haxeko/matter-light-diver/hardware/kicad/output/schematic.pdf

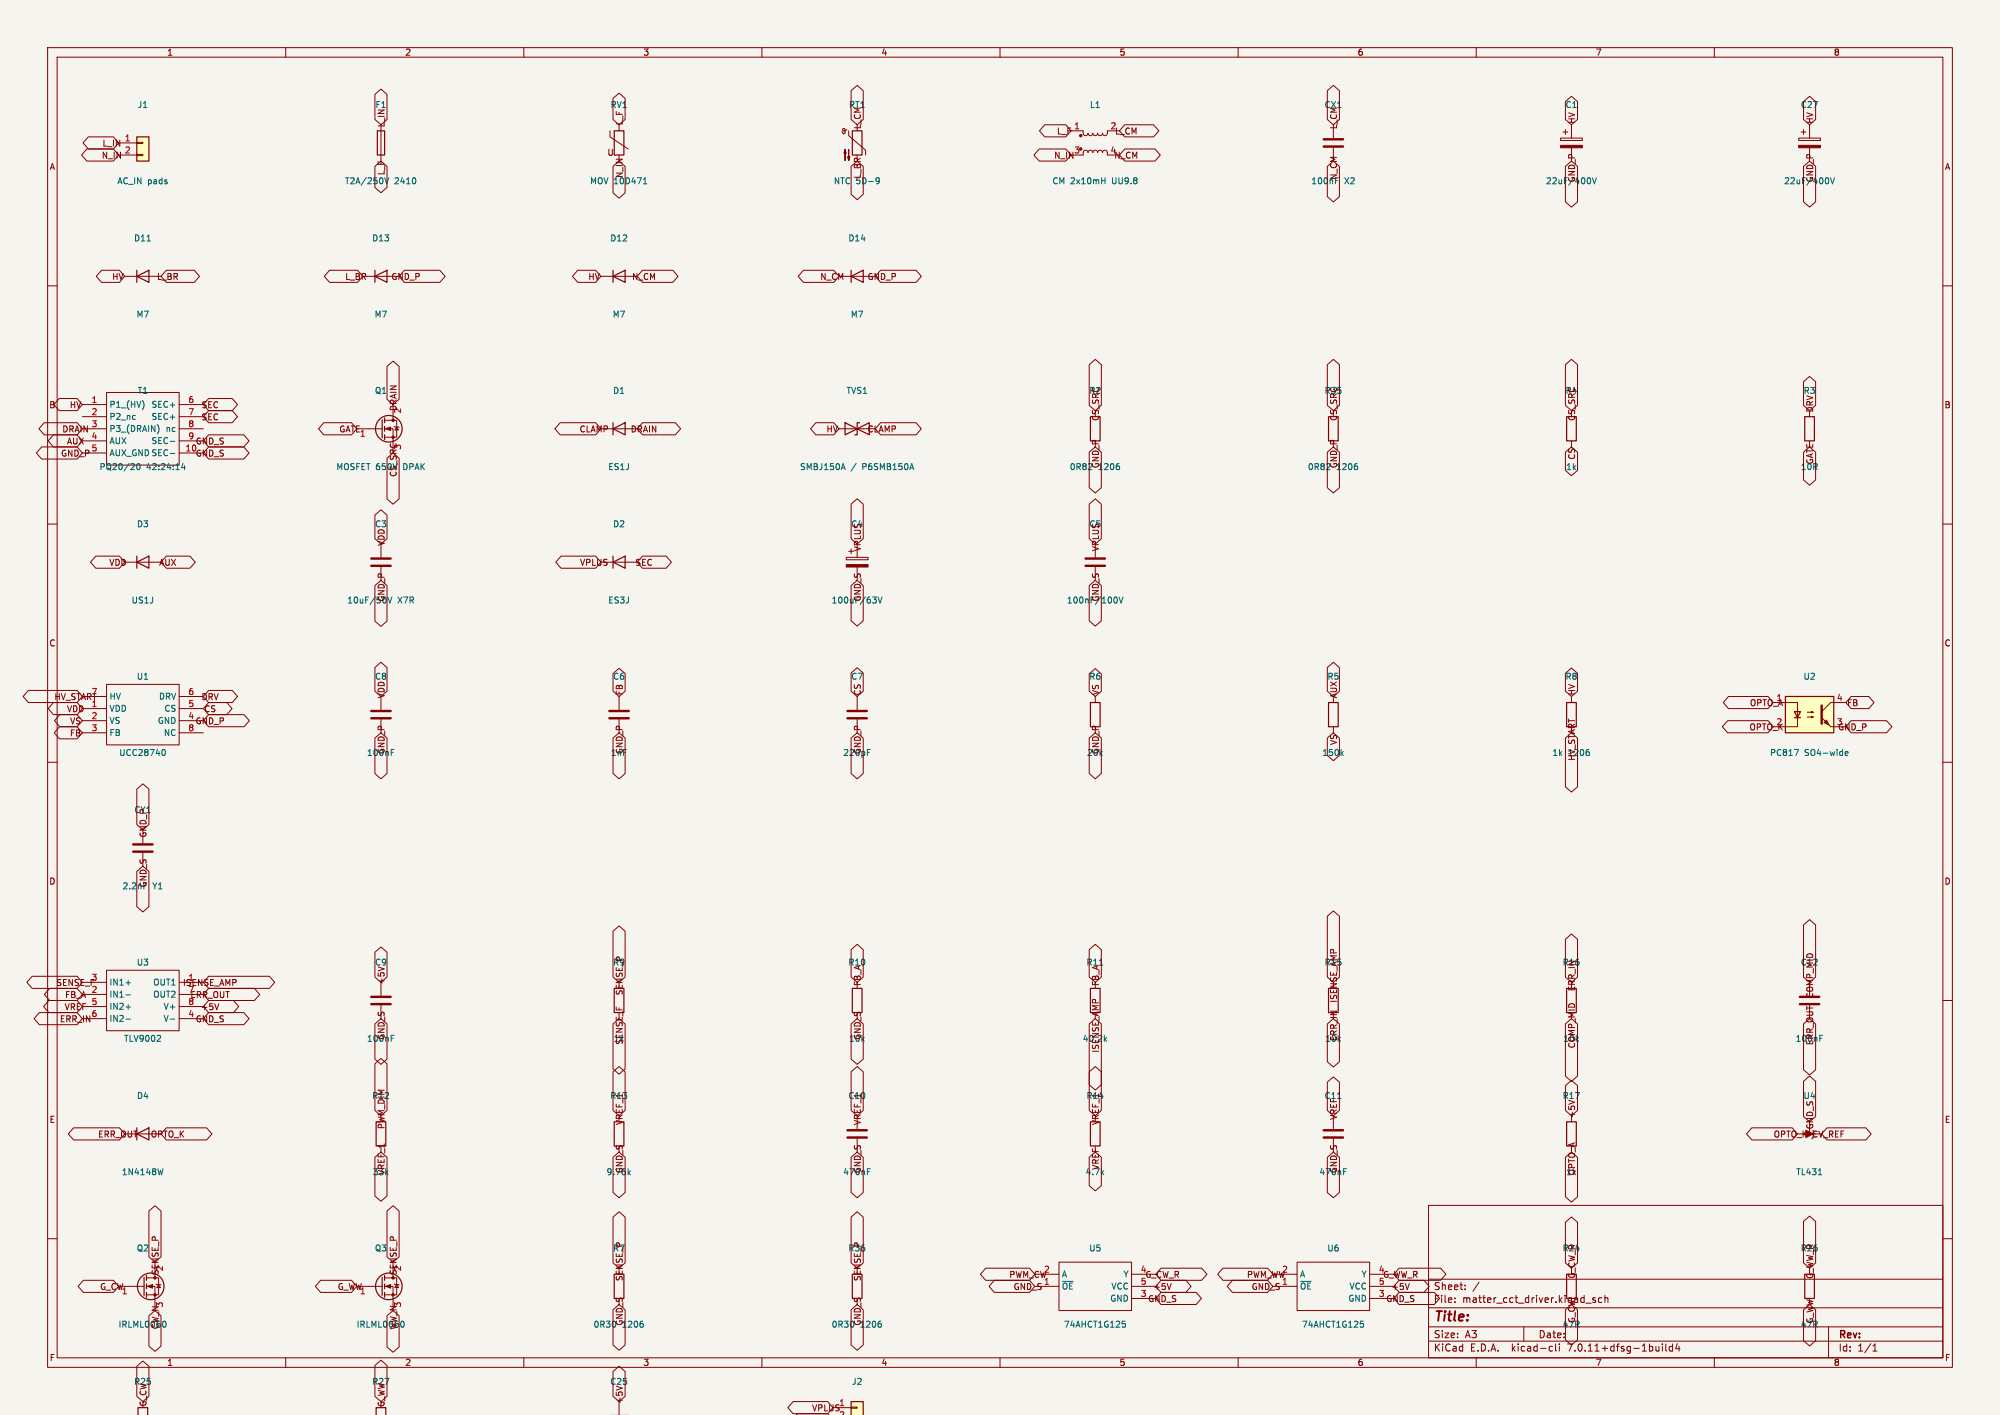
[picture p1: page 1]

Id: 1/1 Title: File: matter_cct_driver.kicad_sch Sheet: / R12

J2 OUT V+ CW- WW- pads C25
