haxeko/matter-light-diver/hardware/kicad/output/pcb_bottom.pdf

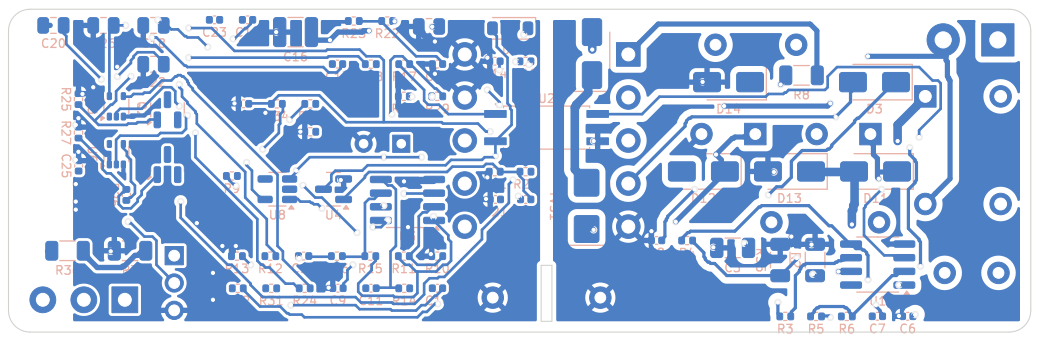
[picture p2: page 1]
