haxeko/matter-light-diver/hardware/kicad/output/pcb_top.pdf

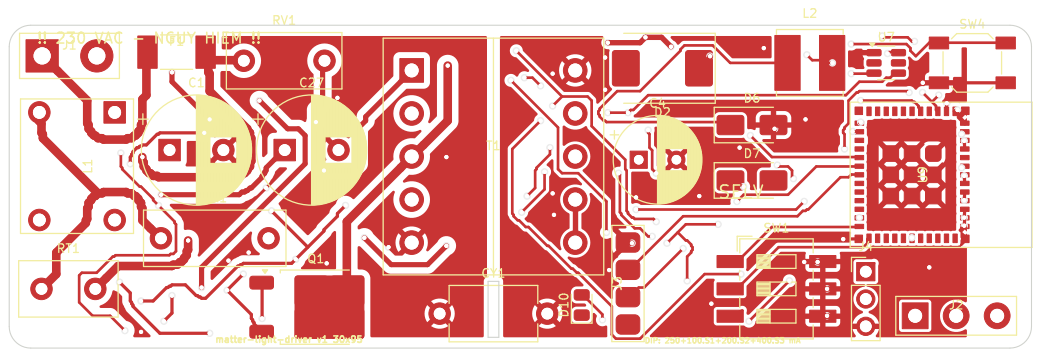
[picture p3: page 1]
