haxeko/matter-light-diver/(list of files, drawings)

Other design files:
hardware/kicad/output/matter_cct_driver.dsn
