haxeko/matter-light-diver/hardware/kicad/matter_cct_driver.kicad_pcb

## KiCad design hardware/kicad/matter_cct_driver.kicad_pcb (2026-11-02)

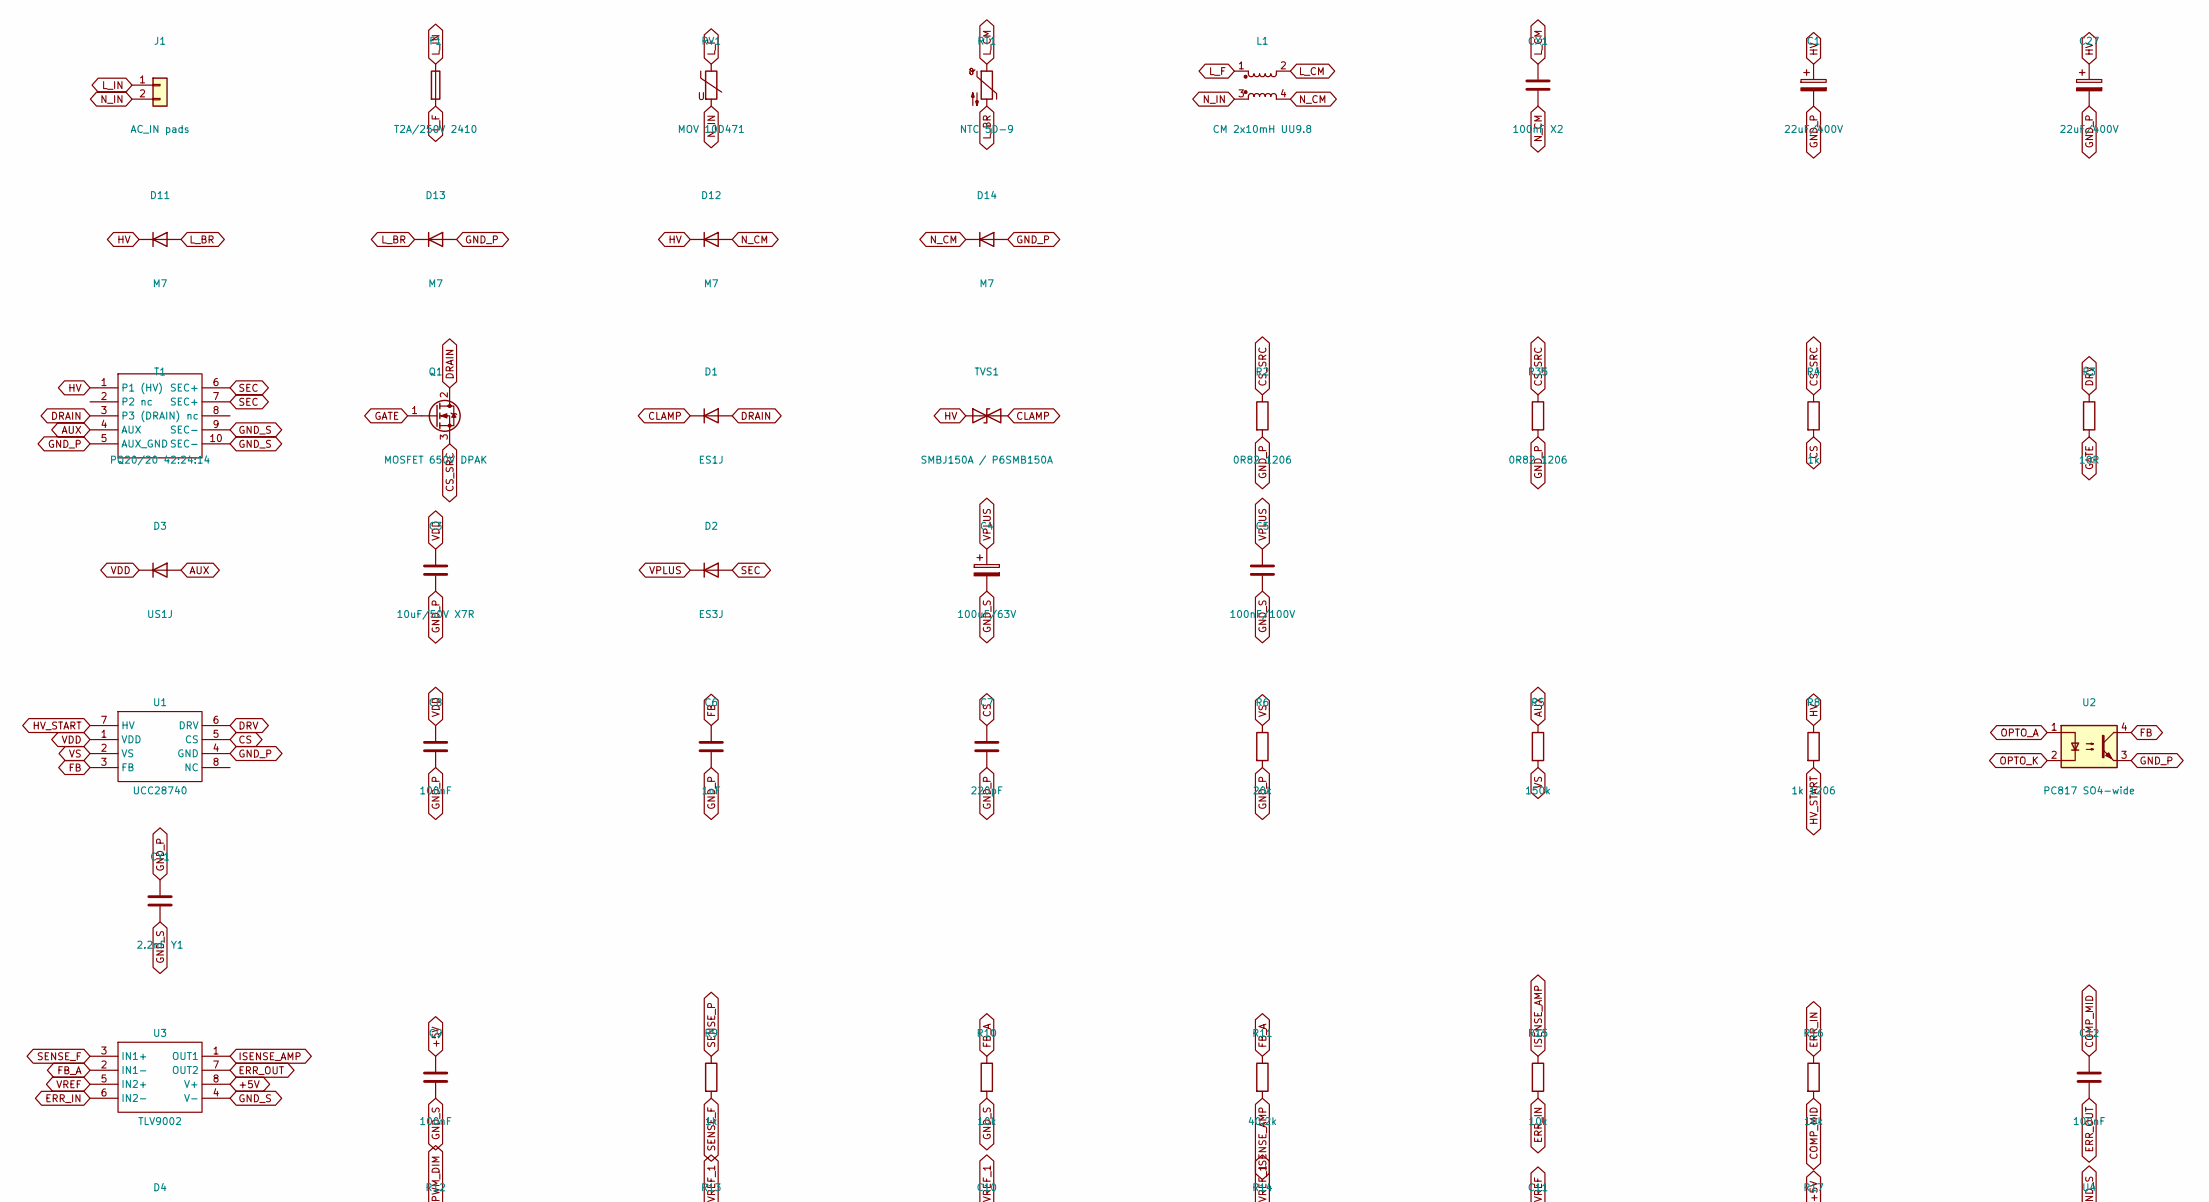
[picture p4: schematic matter_cct_driver.kicad_sch, part in row 1, column 1]

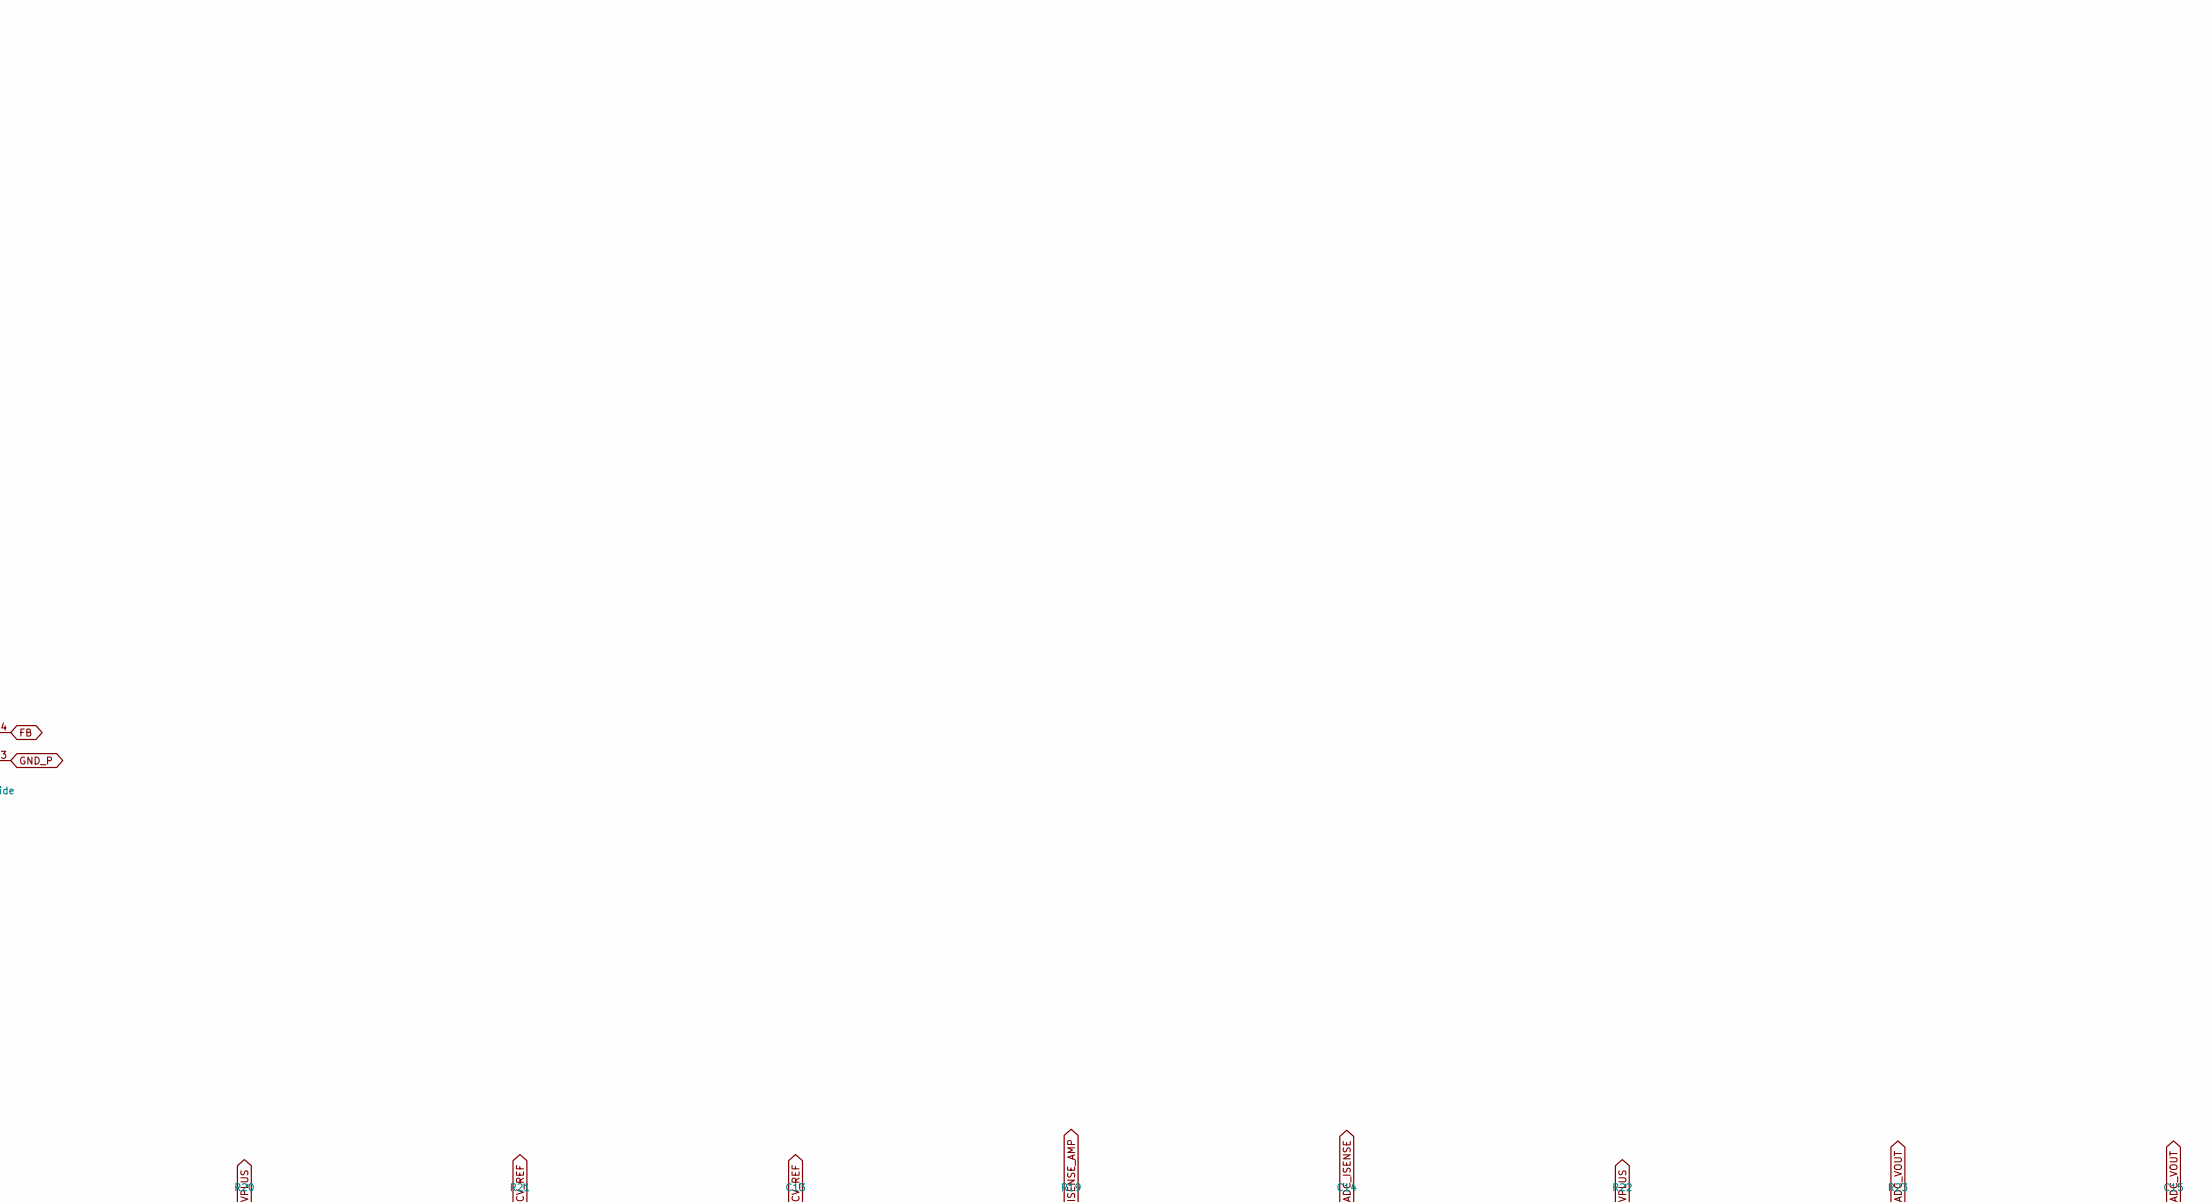
[picture p5: schematic matter_cct_driver.kicad_sch, part in row 1, column 2]

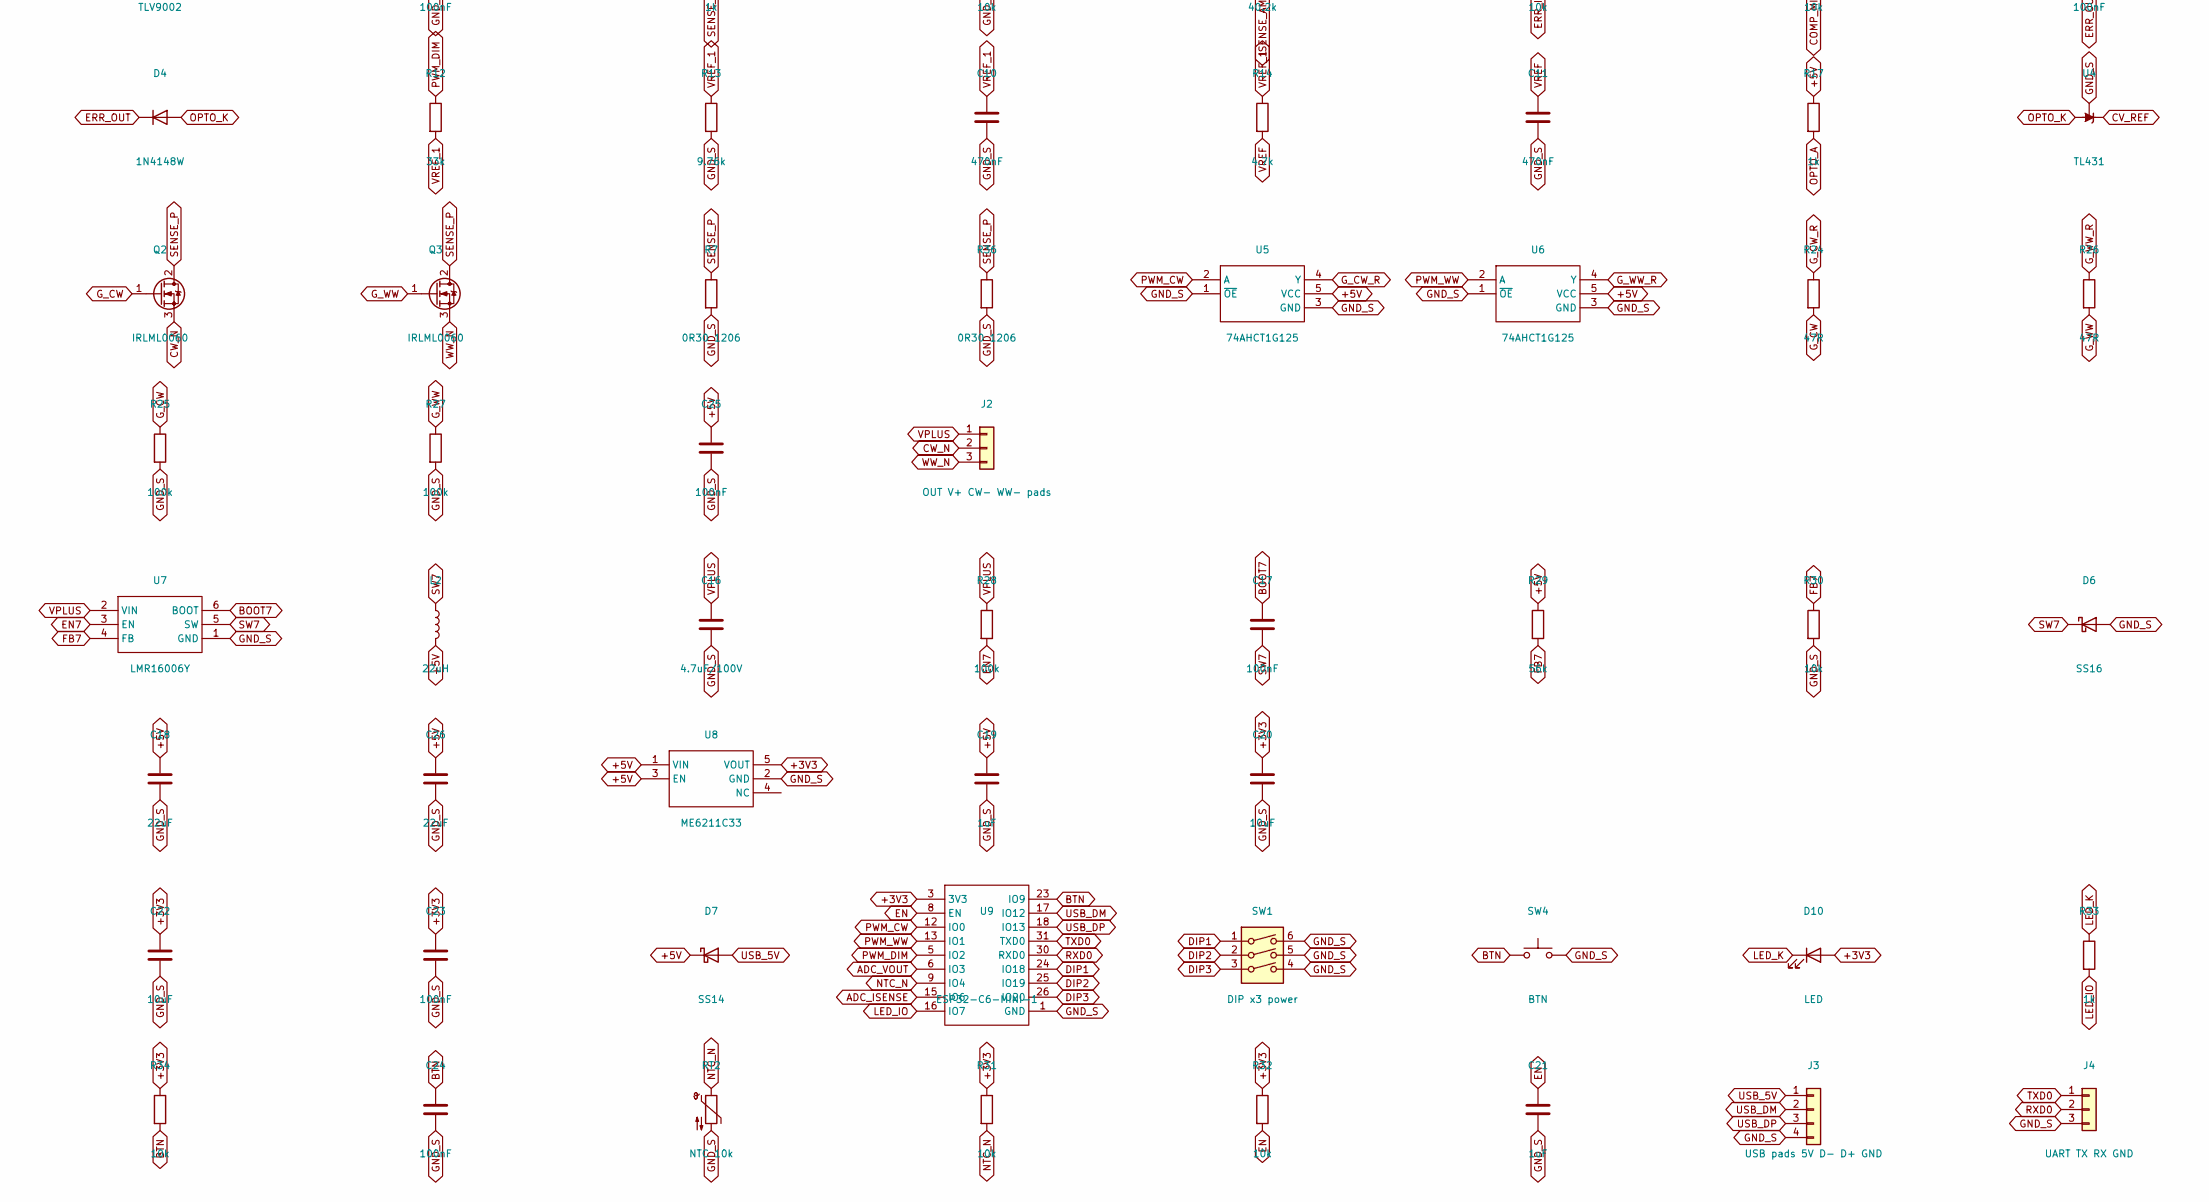
[picture p6: schematic matter_cct_driver.kicad_sch, part in row 2, column 1]

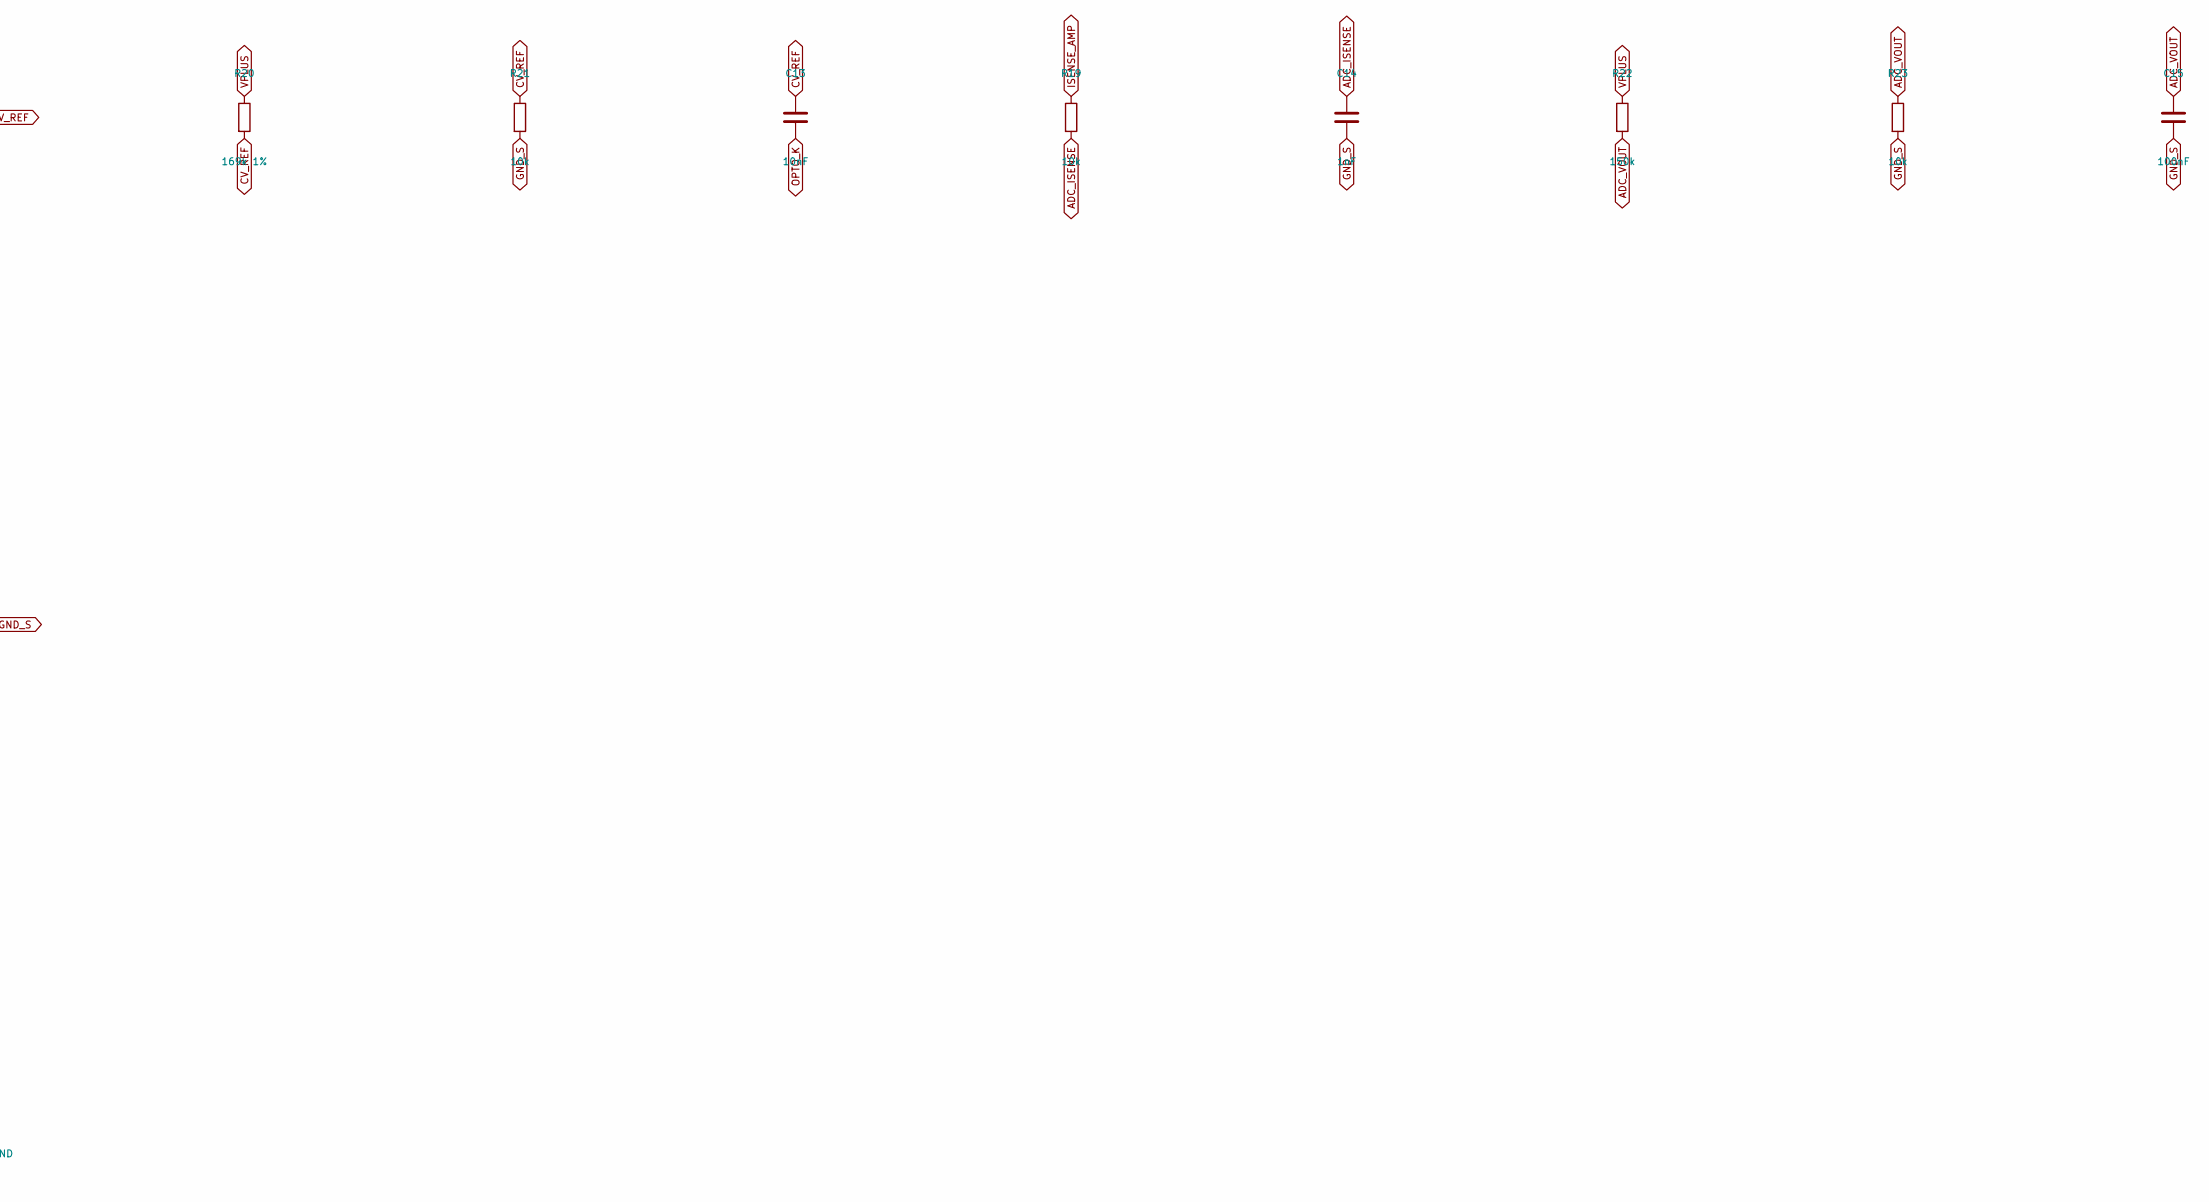
[picture p7: schematic matter_cct_driver.kicad_sch, part in row 2, column 2]

Parts:
C1, C27: 22uF/400V; CP_Radial_D10.0mm_P5.00mm
C3: 10uF/50V X7R; C_1206_3216Metric
C4: 100uF/63V; CP_Radial_D8.0mm_P3.50mm
C5: 100nF/100V; C_0805_2012Metric
C6, C14: 1nF; C_0402_1005Metric
C7: 220pF; C_0402_1005Metric
C8, C9, C12, C15, C17, C23, C24, C25: 100nF; C_0402_1005Metric
C10, C11: 470nF; C_0402_1005Metric
C13: 10nF; C_0402_1005Metric
C16: 4.7uF/100V; C_1210_3225Metric
C18, C26: 22uF; C_0805_2012Metric
C19, C21: 1uF; C_0402_1005Metric
C20, C22: 10uF; C_0805_2012Metric
CX1: 100nF X2; C_Rect_L13.0mm_W5.0mm_P10.00mm_FKS3_FKP3_MKS4
CY1: 2.2nF Y1; C_Disc_D8.0mm_W5.0mm_P10.00mm
D1: ES1J; D_SMA
D2: ES3J; D_SMC
D3: US1J; D_SMA
D4: 1N4148W; D_SOD-123
D6: SS16; D_SMA
D7: SS14; D_SMA
D10: LED; LED_0805_2012Metric
D11, D12, D13, D14: M7; D_SMA
F1: T2A/250V 2410; Fuse_2410_6032Metric
J1: AC_IN pads; WirePads_1x02_P5.08mm
J2: OUT V+ CW- WW- pads; WirePads_1x03_P3.81mm
J3: USB pads 5V D- D+ GND; Pads_1x04_P2.54mm
J4: UART TX RX GND; PinHeader_1x03_P2.54mm_Vertical
L1: CM 2x10mH UU9.8; CM_Choke_UU9.8
L2: 22uH; L_Bourns_SRN6045TA
Q1: MOSFET 650V DPAK; TO-252-2
Q2, Q3: IRLML0060; SOT-23
R2, R35: 0R82 1206; R_1206_3216Metric
R3: 10R; R_0402_1005Metric
R4, R9, R17, R33: 1k; R_0402_1005Metric
R5, R22: 150k; R_0402_1005Metric
R6: 20k; R_0402_1005Metric
R7, R36: 0R30 1206; R_1206_3216Metric
R8: 1k 1206; R_1206_3216Metric
R10, R15, R16, R19, R21, R23, R30, R31, R32, R34: 10k; R_0402_1005Metric
R11: 40.2k; R_0402_1005Metric
R12: 33k; R_0402_1005Metric
R13: 9.76k; R_0402_1005Metric
R14: 4.7k; R_0402_1005Metric
R20: 169k 1%; R_0402_1005Metric
R24, R26: 47R; R_0402_1005Metric
R25, R27, R28: 100k; R_0402_1005Metric
R29: 56k; R_0402_1005Metric
RT1: NTC 5D-9; C_Disc_D9.0mm_W5.0mm_P5.00mm
RT2: NTC 10k; R_0402_1005Metric
RV1: MOV 10D471; C_Disc_D10.5mm_W5.0mm_P7.50mm
SW1: DIP x3 power; SW_DIP_SPSTx03_Slide_6.7x9.18mm_W8.61mm_P2.54mm_LowProfile
SW4: BTN; SW_SPST_SKQG_WithoutStem
T1: PQ20/20 42:24:14; Transformer_PQ20-20_5+5
TVS1: SMBJ150A / P6SMB150A; D_SMB
U1: UCC28740; SOIC-8_3.9x4.9mm_P1.27mm
U2: PC817 SO4-wide; SO-4_7.6x3.6mm_P2.54mm
U3: TLV9002; SOIC-8_3.9x4.9mm_P1.27mm
U4: TL431; SOT-23
U5, U6: 74AHCT1G125; SOT-353_SC-70-5
U7: LMR16006Y; SOT-23-6
U8: ME6211C33; SOT-23-5
U9: ESP32-C6-MINI-1

Connections:
+3V3: C20.1, C22.1, C23.1, D10.2 (A), R31.1, R32.1, R34.1, U8.5 (VOUT), U9.3 (3V3)
+5V: C9.1, C18.1, C19.1, C25.1, C26.1, D7.1 (K), L2.2, R17.1, R29.1, U3.8 (V+), U5.5 (VCC), U6.5 (VCC), U8.1 (VIN), U8.3 (EN)
ADC_ISENSE: C14.1, R19.2, U9.15 (IO6)
ADC_VOUT: C15.1, R22.2, R23.1, U9.6 (IO3)
AUX: D3.2 (A), R5.1, T1.4 (AUX)
BOOT7: C17.1, U7.6 (BOOT)
BTN: C24.1, R34.2, SW4.1, U9.23 (IO9)
CLAMP: D1.1 (K), TVS1.2 (A2)
COMP_MID: C12.1, R16.2
CS: C7.1, R4.2, U1.5 (CS)
CS_SRC: Q1.3 (S), R2.1, R4.1, R35.1
CV_REF: C13.1, R20.2, R21.1, U4.1 (K)
CW_N: J2.2, Q2.3 (S)
DIP1: SW1.1, U9.24 (IO18)
DIP2: SW1.2, U9.25 (IO19)
DIP3: SW1.3, U9.26 (IO20)
DRAIN: D1.2 (A), Q1.2 (D), T1.3 (P3 (DRAIN))
DRV: R3.1, U1.6 (DRV)
EN: C21.1, R32.2, U9.8 (EN)
EN7: R28.2, U7.3 (EN)
ERR_IN: R15.2, R16.1, U3.6 (IN2-)
ERR_OUT: C12.2, D4.1 (K), U3.7 (OUT2)
FB: C6.1, U1.3 (FB), U2.4
FB7: R29.2, R30.1, U7.4 (FB)
FB_A: R10.1, R11.1, U3.2 (IN1-)
GATE: Q1.1 (G), R3.2
GND_P: C1.2, C3.2, C6.2, C7.2, C8.2, C27.2, CY1.1, D13.2 (A), D14.2 (A), R2.2, R6.2, R35.2, T1.5 (AUX_GND), U1.4 (GND), U2.3
GND_S: C4.2, C5.2, C9.2, C10.2, C11.2, C14.2, C15.2, C16.2, C18.2, C19.2, C20.2, C21.2, C22.2, C23.2, C24.2, C25.2, C26.2, CY1.2, D6.2 (A), J3.4, J4.3, R7.2, R10.2, R13.2, R21.2, R23.2, R25.2, R27.2, R30.2, R36.2, RT2.2, SW1.4, SW1.5, SW1.6, SW4.2, T1.9 (SEC-), T1.10 (SEC-), U3.4 (V-), U4.2 (REF), U5.1 (~OE), U5.3 (GND), U6.1 (~OE), U6.3 (GND), U7.1 (GND), U8.2 (GND), U9.1 (GND), U9.2 (GND), U9.11 (GND), U9.14 (GND), U9.36 (GND), U9.37 (GND), U9.38 (GND), U9.39 (GND), U9.40 (GND), U9.41 (GND), U9.42 (GND), U9.43 (GND), U9.44 (GND), U9.45 (GND), U9.46 (GND), U9.47 (GND), U9.48 (GND), U9.49 (GND), U9.50 (GND), U9.51 (GND), U9.52 (GND), U9.53 (GND)
G_CW: Q2.1 (G), R24.2, R25.1
G_CW_R: R24.1, U5.4 (Y)
G_WW: Q3.1 (G), R26.2, R27.1
G_WW_R: R26.1, U6.4 (Y)
HV: C1.1, C27.1, D11.1 (K), D12.1 (K), R8.1, T1.1 (P1 (HV)), TVS1.1 (A1)
HV_START: R8.2, U1.7 (HV)
ISENSE_AMP: R11.2, R15.1, R19.1, U3.1 (OUT1)
LED_IO: R33.2, U9.16 (IO7)
LED_K: D10.1 (K), R33.1
L_BR: D11.2 (A), D13.1 (K), RT1.2
L_CM: CX1.1, L1.2, RT1.1
L_F: F1.2, L1.1, RV1.1
L_IN: F1.1, J1.1
NTC_N: R31.2, RT2.1, U9.9 (IO4)
N_CM: CX1.2, D12.2 (A), D14.1 (K), L1.4
N_IN: J1.2, L1.3, RV1.2
OPTO_A: R17.2, U2.1
OPTO_K: C13.2, D4.2 (A), U2.2, U4.3 (A)
PWM_CW: U5.2 (A), U9.12 (IO0)
PWM_DIM: R12.1, U9.5 (IO2)
PWM_WW: U6.2 (A), U9.13 (IO1)
RXD0: J4.2, U9.30 (RXD0)
SEC: D2.2 (A), T1.6 (SEC+), T1.7 (SEC+)
SENSE_F: R9.2, U3.3 (IN1+)
SENSE_P: Q2.2 (D), Q3.2 (D), R7.1, R9.1, R36.1
SW7: C17.2, D6.1 (K), L2.1, U7.5 (SW)
TXD0: J4.1, U9.31 (TXD0)
USB_5V: D7.2 (A), J3.1
USB_DM: J3.2, U9.17 (IO12)
USB_DP: J3.3, U9.18 (IO13)
VDD: C3.1, C8.1, D3.1 (K), U1.1 (VDD)
VPLUS: C4.1, C5.1, C16.1, D2.1 (K), J2.1, R20.1, R22.1, R28.1, U7.2 (VIN)
VREF: C11.1, R14.2, U3.5 (IN2+)
VREF_1: C10.1, R12.2, R13.1, R14.1
VS: R5.2, R6.1, U1.2 (VS)
WW_N: J2.3, Q3.3 (S)

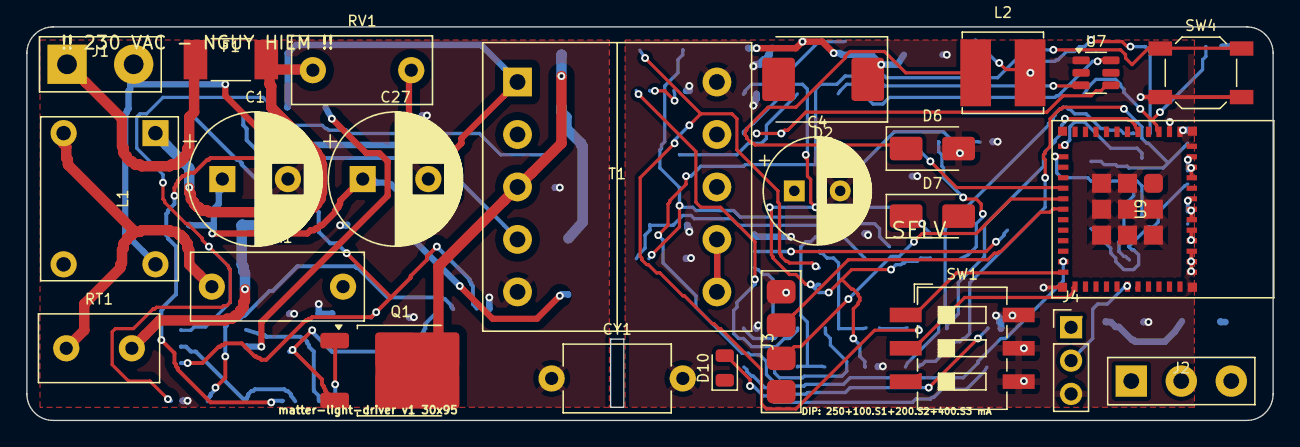
[picture p8: board matter_cct_driver.kicad_pcb from above]

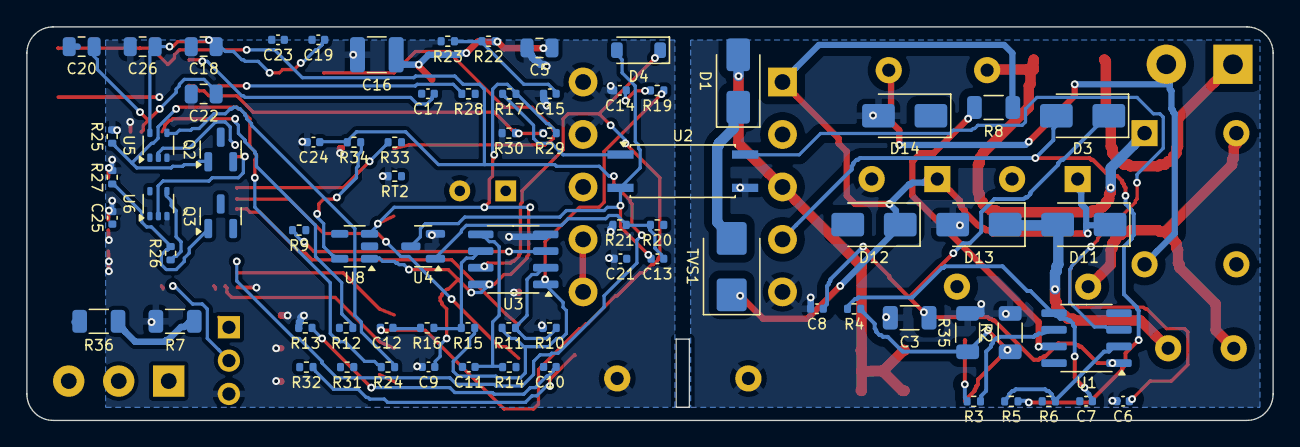
[picture p9: board matter_cct_driver.kicad_pcb from below]

Board: 2 copper layers, 95.0 x 30.0 mm, 99 parts (75 on the bottom side), 64 nets.
