haxeko/matter-light-diver/(commit log)

2026-11-02 Add CCT 3-wire LED driver design: docs, schematics, calculators, floorplan, BOM and ESP32-C6 Matter/Thread firmware
    - docs/01-07: requirements, isolated flyback design, secondary CC/CV loop,
    MCU, PCB layout, firmware, test/safety plan (Vietnamese)
    - hardware/calc: flyback and secondary-side calculators
    - hardware/schematics: 7 schemdraw-generated schematic blocks + net table
    - hardware/pcb: 30x90 mm floorplan generator
    - docs/bom/BOM.csv: bill of materials with LCSC alternatives
    - firmware: ESP-IDF/esp-matter project (color temperature light over Thread),
    host-tested light engine, DIP power selection, soft-connect, protections
    Cla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
    [BOM.csv, partitions.csv]
2026-11-02 Move polarity note in flyback stage drawing
    Claude-Session: https://claude.ai/code/session_01TvrXHVgonXEgkeenVZV4N5
2026-11-02 Add KiCad 7 project: PCB layout, schematic, footprints, Gerbers for the CCT driver
    Script-generated KiCad project in hardware/kicad built from a single design
    database (design_db.py):
    - PCB 30 x 95 mm, 2 layers, 99 footprints, placed by region packer with
    isolation barrier, milled slot under the Y1 capacitor, antenna keepouts and
    separate GND_P / GND_S copper zones
    - custom footprints (ESP32-C6-MINI-1, PQ20/20 transformer, UU9.8 choke,
    wire pads, 2410 fuse) and generated symbol library
    - own grid router plus GND via-stub fixer: 160 of 230 connections routed,
    routed part is DRC clean; remaining ratsnest left for manual finish or
    Freerouting (Specctra DSN exported)
    - connectivity sch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
    [BOM.csv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]
